jmsweng/15-1-cycloidal-drive/Pinion mount/readme.md

### Pinion mount for detector tables at 11-ID-B, 11-ID-C, and 11-ID-D

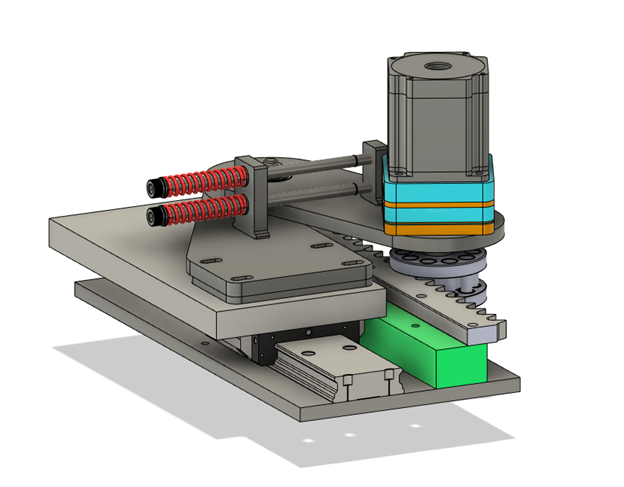
[picture p1: Pinion mount/Pictures/Pinion mount assembly.png]
Pinion mount assembly


Assembly pictured with 15:1 cycloidal gearbox mounted on a NEMA 34 stepper motor with an RPS-20 pinion

Assembly instructions
Components list is contained in assembly instructions.
