jmsweng/15-1-cycloidal-drive/Pinion mount/Component drawings/Old/readme.md

Drawings left for historical reasons, don't use.
