jmsweng/15-1-cycloidal-drive/Individual components/DXF Fies/Gearbox base, mild steel, 0.187.dxf

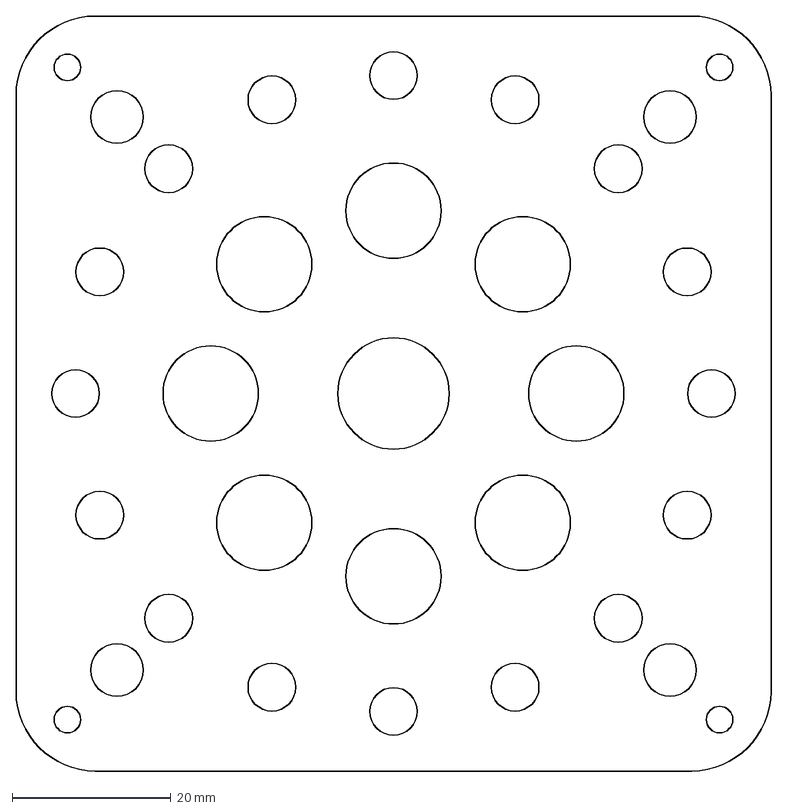
[picture p2: CAD file, 2024-03-28]
Individual components/DXF Fies/Gearbox base, mild steel, 0.187.dxf
95.0 x 95.0 mm
