jmsweng/15-1-cycloidal-drive/Individual components/Printed parts/Motor to gearbox spacer, printed.step

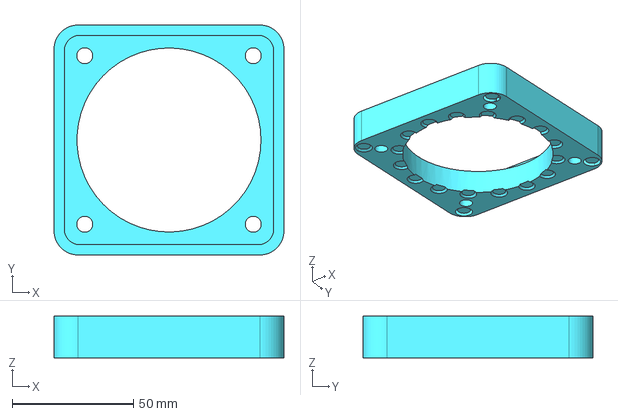
[picture p3: CAD file, 2024-03-28]
Individual components/Printed parts/Motor to gearbox spacer, printed.step
95.0 x 95.0 x 17.2 mm
