jmsweng/15-1-cycloidal-drive/Individual components/Step files/Output hub plate 2, 4130, 0.190.step

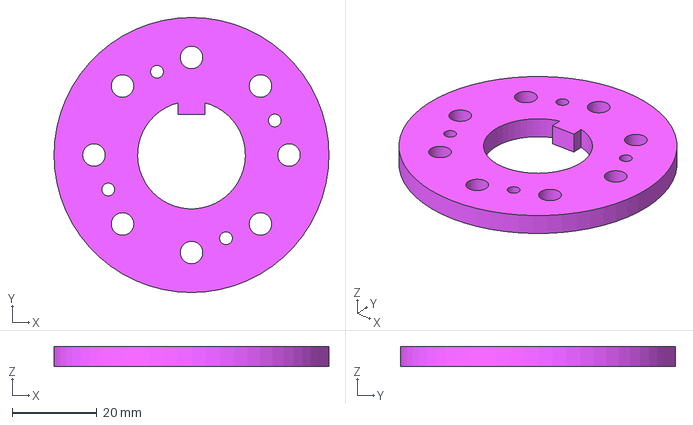
[picture p4: CAD file, 2024-03-28]
Individual components/Step files/Output hub plate 2, 4130, 0.190.step
64.8 x 64.8 x 4.83 mm
