jmsweng/15-1-cycloidal-drive/Pinion mount/Component drawings/Base plate, v2.step

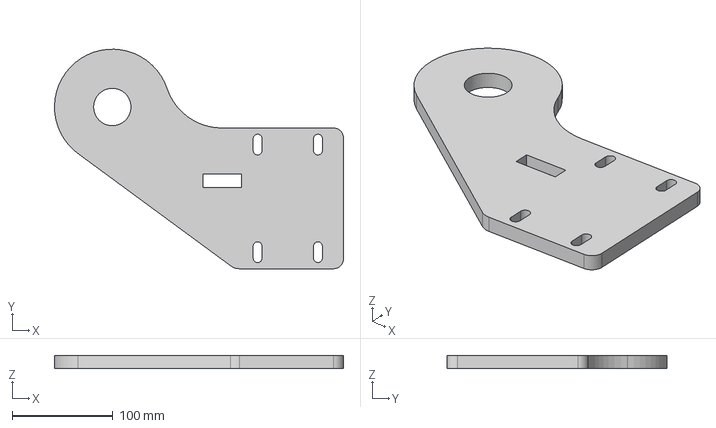
[picture p5: CAD file, 2024-06-21]
Pinion mount/Component drawings/Base plate, v2.step
287.3 x 218.3 x 12.7 mm
