jmsweng/15-1-cycloidal-drive/Pinion mount/Pinion mount.step

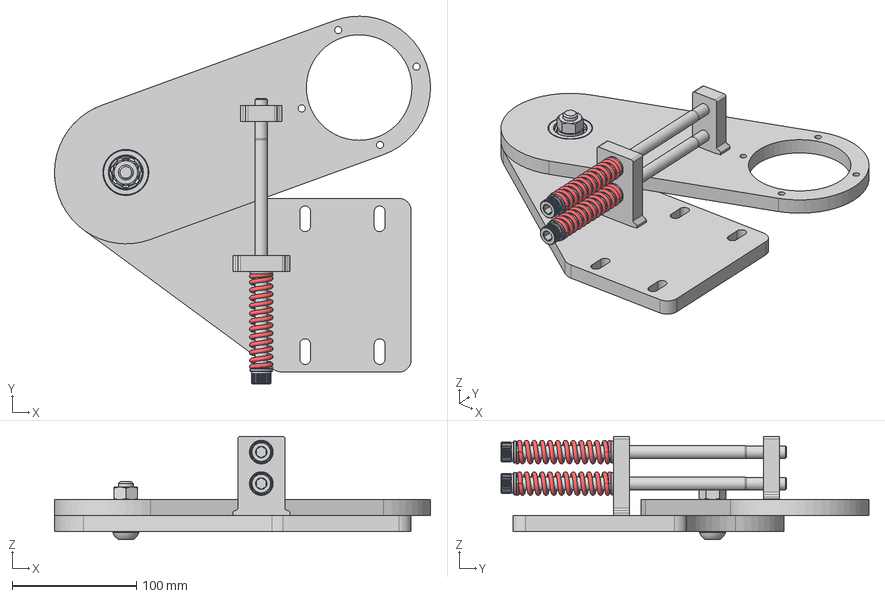
[picture p6: CAD file, 2024-06-21]
Pinion mount/Pinion mount.step
302.9 x 296.2 x 83.0 mm
5972K318_Ball Bearing x 2
90593A009_NO THREADS_Black-Oxide Steel Hex Nut
98687A138_General Purpose Steel Washer x 4
9657K438_Compression Spring x 2
91290A160_NO THREADS_Alloy Steel Socket Head Screw x 2
91239A620_NO THREADS
