jmsweng/15-1-cycloidal-drive/Individual components/DXF Fies/Gearbox pin retaining plate, Mild steel, 0.048.dxf

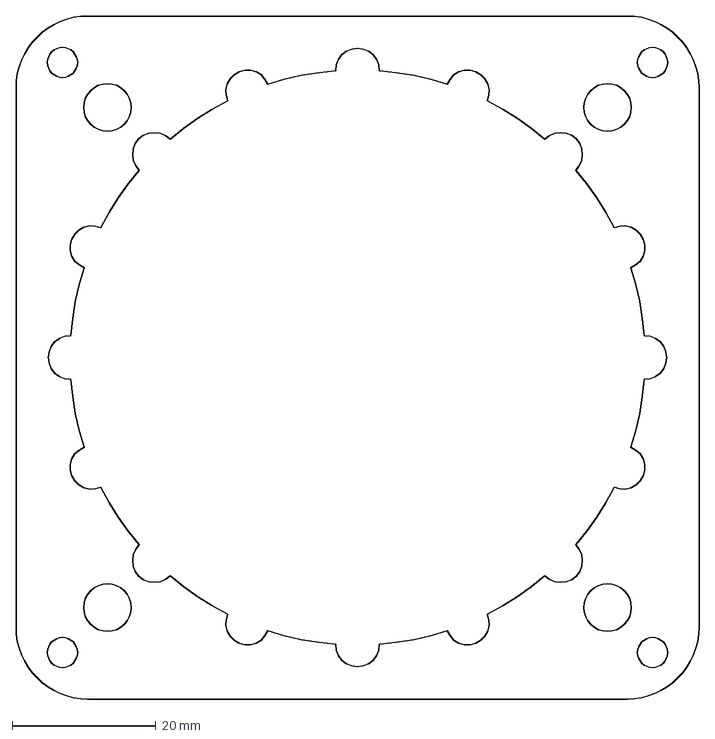
[picture p7: CAD file, 2024-03-28]
Individual components/DXF Fies/Gearbox pin retaining plate, Mild steel, 0.048.dxf
95.0 x 95.0 mm
