jmsweng/15-1-cycloidal-drive/Individual components/Printed parts/Input hub spacers.step

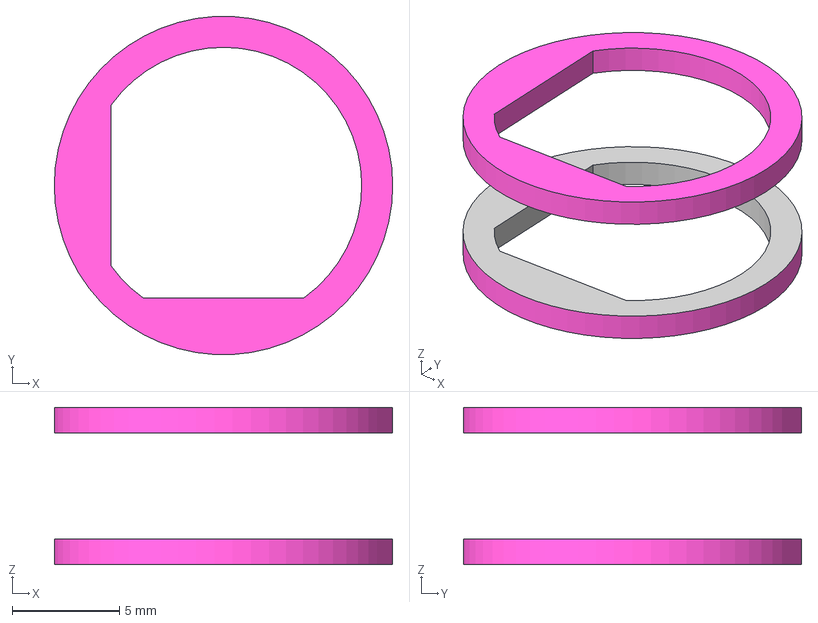
[picture p8: CAD file, 2024-03-28]
Individual components/Printed parts/Input hub spacers.step
15.8 x 15.8 x 7.34 mm
