jmsweng/15-1-cycloidal-drive/Individual components/Step files/Cycloidal disk, 4130, 0.190.step

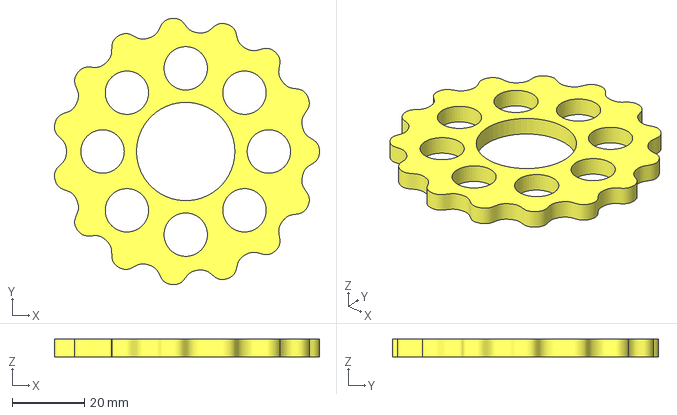
[picture p9: CAD file, 2024-03-28]
Individual components/Step files/Cycloidal disk, 4130, 0.190.step
73.3 x 73.6 x 4.87 mm
