jmsweng/15-1-cycloidal-drive/Pinion mount/Component drawings/Bearing spacer.step

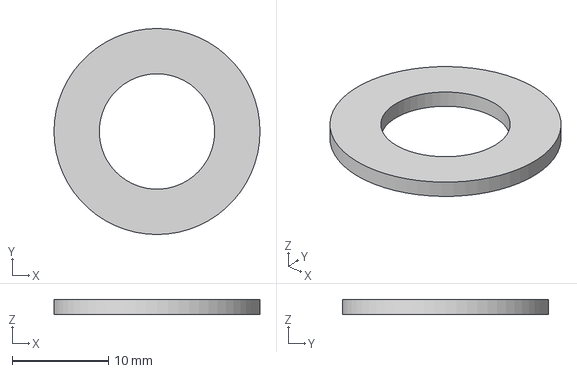
[picture p10: CAD file, 2024-04-02]
Pinion mount/Component drawings/Bearing spacer.step
21.4 x 21.4 x 1.52 mm
