jmsweng/15-1-cycloidal-drive/Individual components/Printed parts/Gearbox housing, plastic.step

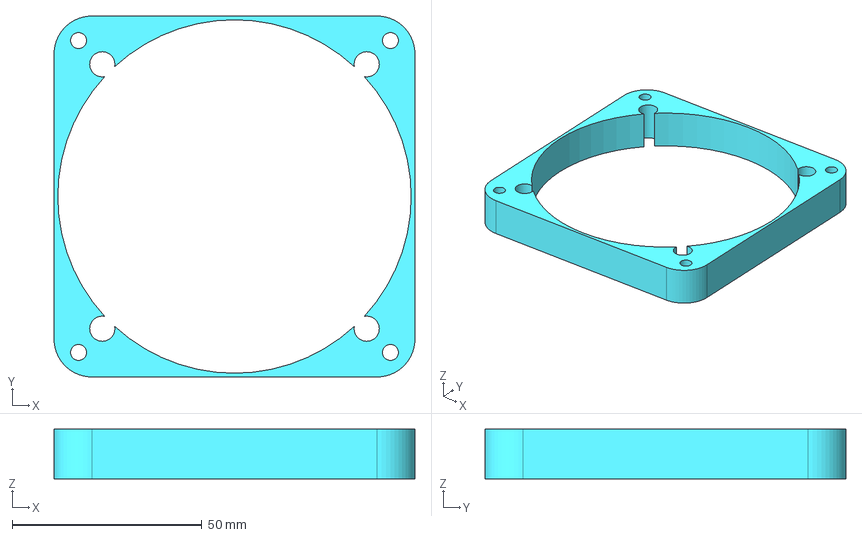
[picture p12: CAD file, 2024-03-28]
Individual components/Printed parts/Gearbox housing, plastic.step
95.0 x 95.0 x 13.1 mm
