jmsweng/15-1-cycloidal-drive/Individual components/Step files/Input concentric cam, 4130, 0.190.step

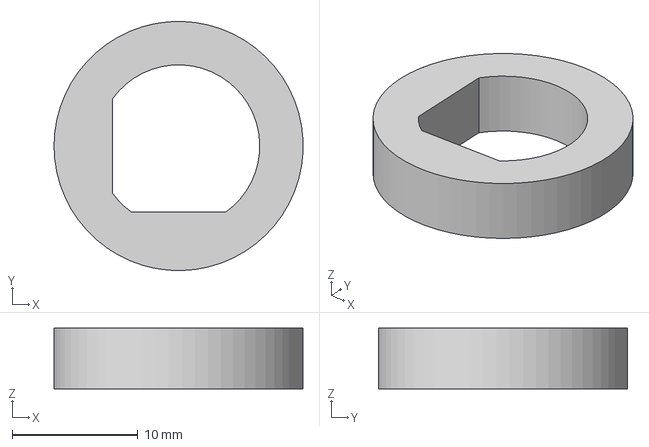
[picture p13: CAD file, 2024-03-28]
Individual components/Step files/Input concentric cam, 4130, 0.190.step
19.8 x 19.8 x 4.83 mm
