jmsweng/15-1-cycloidal-drive/Pinion mount/Component drawings/Tensioning spring retainer.step

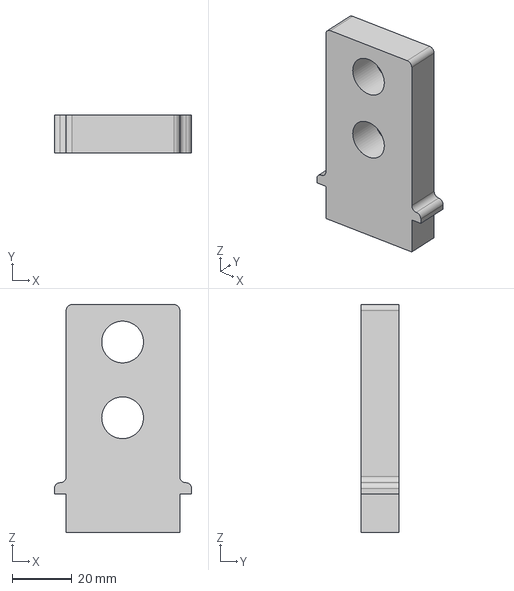
[picture p14: CAD file, 2024-04-02]
Pinion mount/Component drawings/Tensioning spring retainer.step
46.1 x 12.7 x 76.4 mm
