jmsweng/15-1-cycloidal-drive/Individual components/Printed parts/Gearbox pin retaining plate, plastic.step

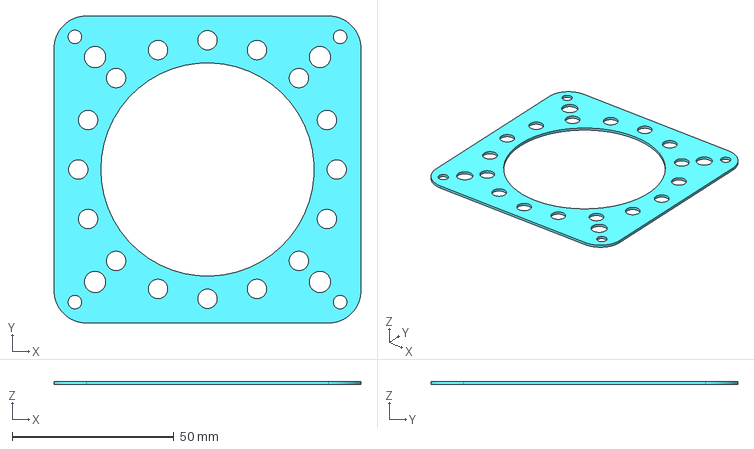
[picture p16: CAD file, 2024-03-28]
Individual components/Printed parts/Gearbox pin retaining plate, plastic.step
95.0 x 95.0 x 1.00 mm
