jmsweng/15-1-cycloidal-drive/Pinion mount/Component drawings/Top arm.step

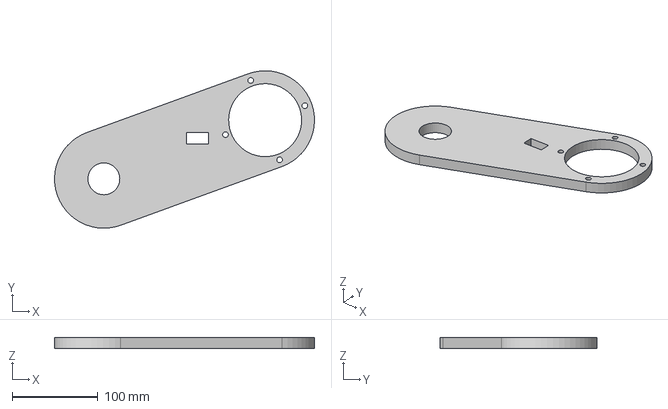
[picture p17: CAD file, 2024-04-02]
Pinion mount/Component drawings/Top arm.step
302.9 x 183.4 x 12.7 mm
