jmsweng/15-1-cycloidal-drive/Individual components/DXF Fies/Input concentric cam, 4130, 0.190.dxf

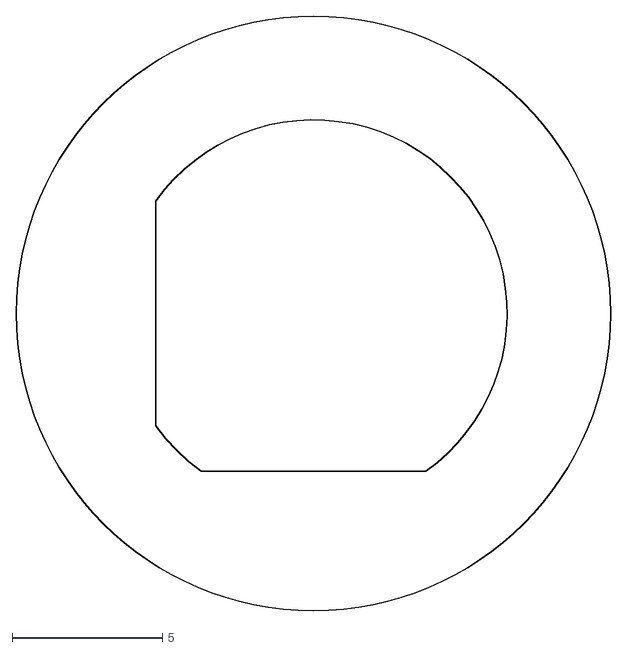
[picture p18: CAD file, 2024-03-28]
Individual components/DXF Fies/Input concentric cam, 4130, 0.190.dxf
19.8 x 19.8
