jmsweng/15-1-cycloidal-drive/Individual components/Printed parts/Ring pin spacers.step

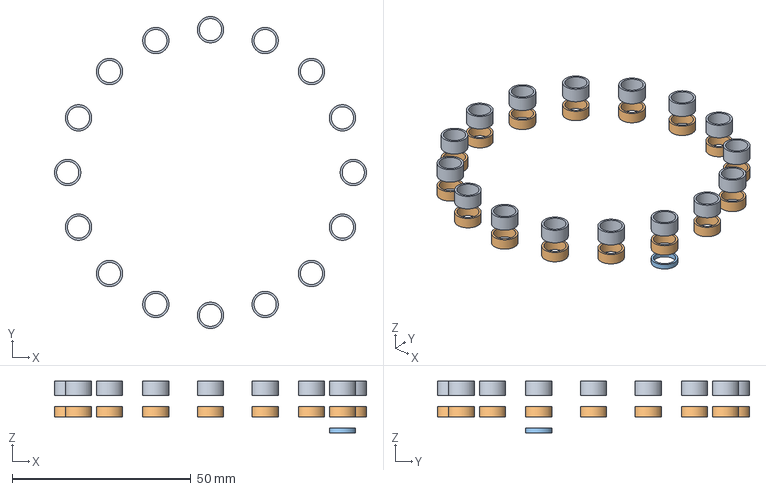
[picture p19: CAD file, 2024-03-28]
Individual components/Printed parts/Ring pin spacers.step
87.4 x 87.4 x 14.5 mm
