jmsweng/15-1-cycloidal-drive/Individual components/DXF Fies/Unnamed-Shape2DView.dxf

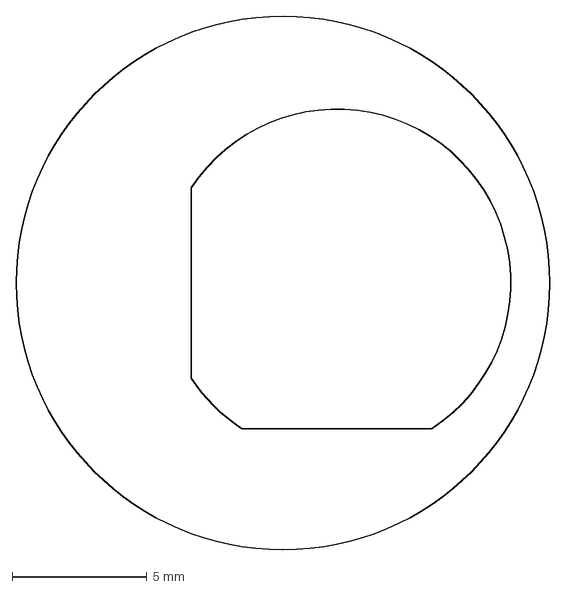
[picture p20: CAD file, 2024-03-28]
Individual components/DXF Fies/Unnamed-Shape2DView.dxf
19.8 x 19.8 mm
