jmsweng/15-1-cycloidal-drive/Individual components/Step files/Gearbox base, mild steel, 0.187.step

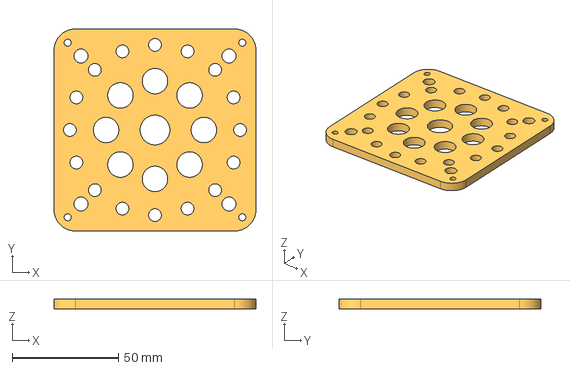
[picture p21: CAD file, 2024-03-28]
Individual components/Step files/Gearbox base, mild steel, 0.187.step
95.0 x 95.0 x 4.75 mm
