jmsweng/15-1-cycloidal-drive/Pinion mount/Component drawings/Base plate spacer.step

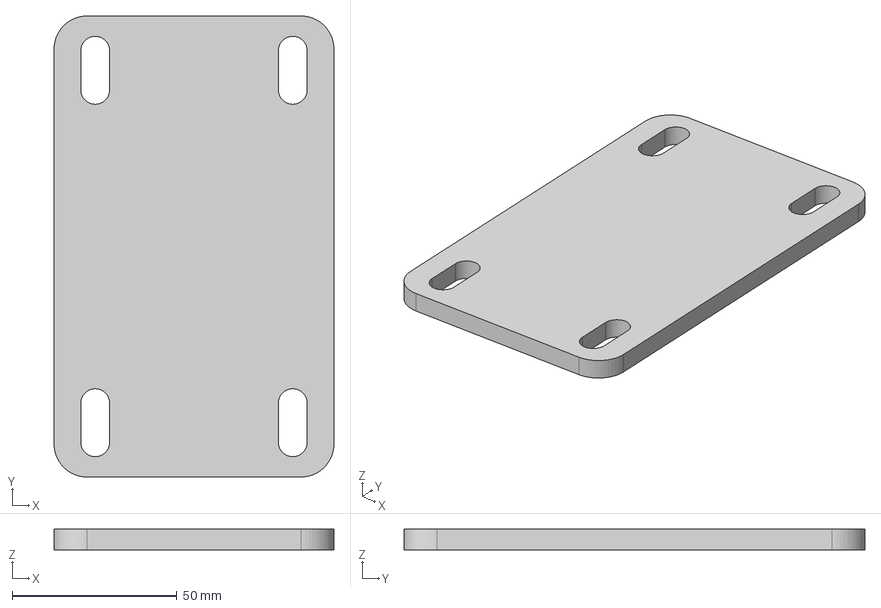
[picture p22: CAD file, 2024-04-02]
Pinion mount/Component drawings/Base plate spacer.step
85.0 x 140.0 x 6.35 mm
