jmsweng/15-1-cycloidal-drive/Individual components/DXF Fies/Gearbox output bearing plate, mild steel, 0.375.dxf

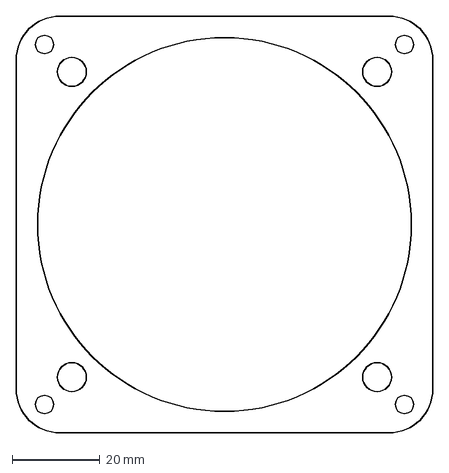
[picture p23: CAD file, 2024-03-28]
Individual components/DXF Fies/Gearbox output bearing plate, mild steel, 0.375.dxf
95.0 x 95.0 mm
