jmsweng/15-1-cycloidal-drive/Pinion mount/Component drawings/Tensioning tab, threaded.step

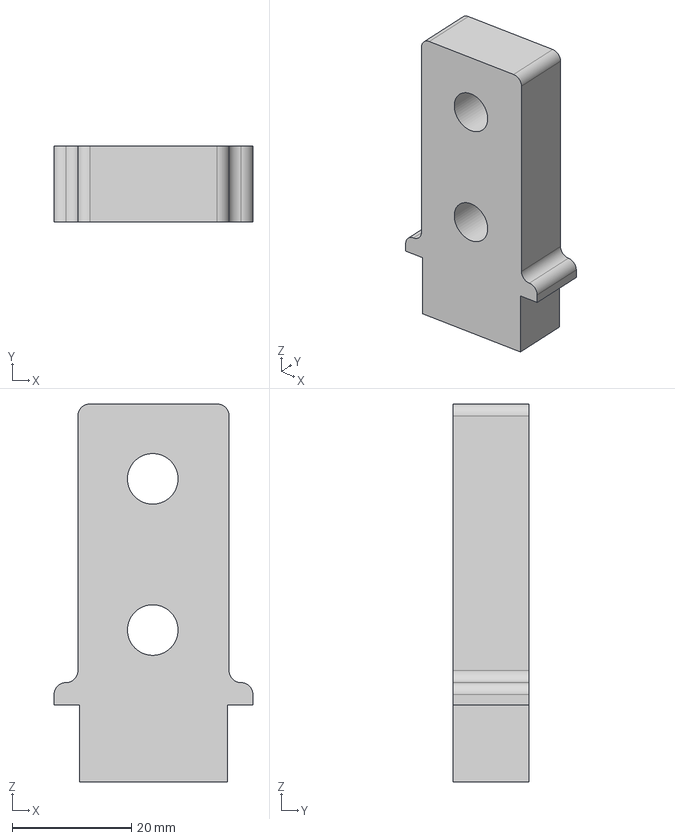
[picture p24: CAD file, 2024-04-02]
Pinion mount/Component drawings/Tensioning tab, threaded.step
33.4 x 12.7 x 63.5 mm
