jmsweng/15-1-cycloidal-drive/Individual components/DXF Fies/Output hub plate 1, 4130, 0.190.dxf

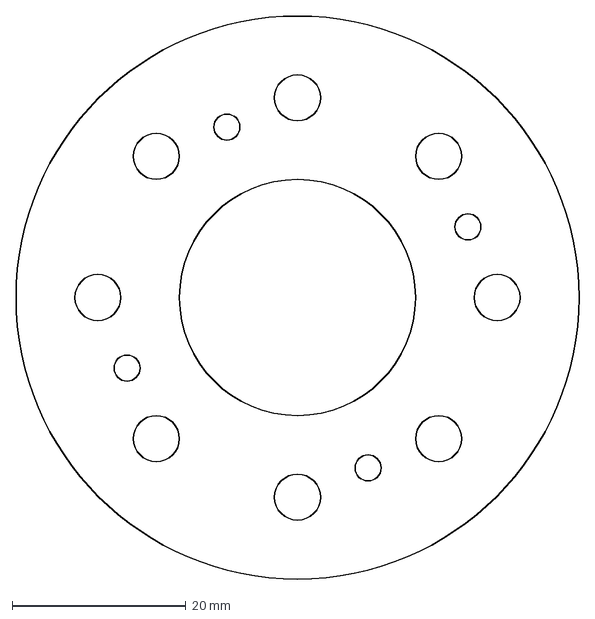
[picture p25: CAD file, 2024-03-28]
Individual components/DXF Fies/Output hub plate 1, 4130, 0.190.dxf
64.8 x 64.8 mm
