jmsweng/15-1-cycloidal-drive/Individual components/Step files/Gearbox output bearing plate, mild steel, 0.375.step

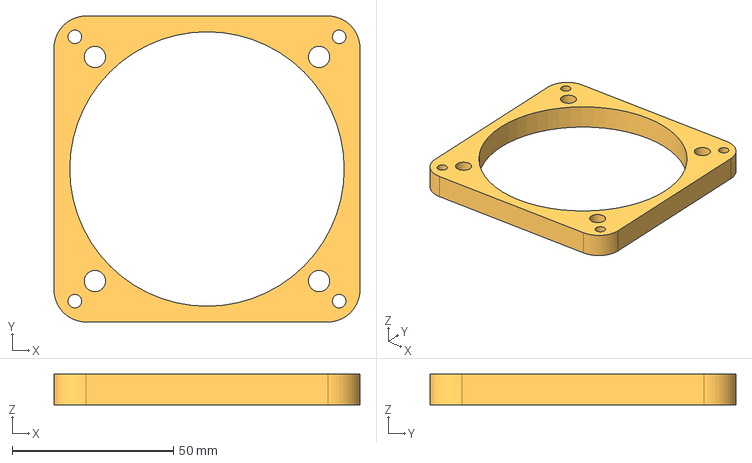
[picture p26: CAD file, 2024-03-28]
Individual components/Step files/Gearbox output bearing plate, mild steel, 0.375.step
95.0 x 95.0 x 9.53 mm
