jmsweng/15-1-cycloidal-drive/Pinion mount/Component drawings/Carriage spacer.step

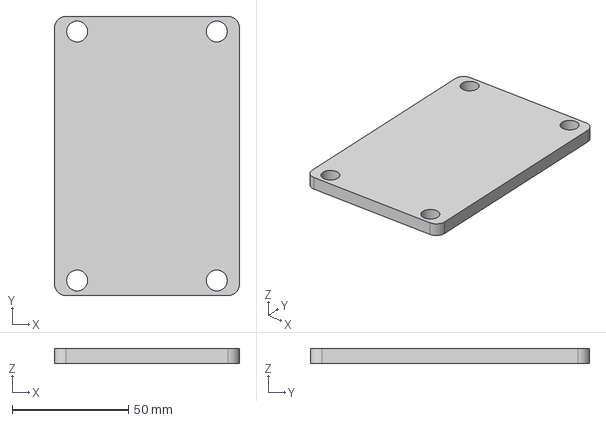
[picture p27: CAD file, 2024-04-02]
Pinion mount/Component drawings/Carriage spacer.step
79.5 x 120.0 x 6.36 mm
