jmsweng/15-1-cycloidal-drive/Pinion mount/Component drawings/Base plate.step

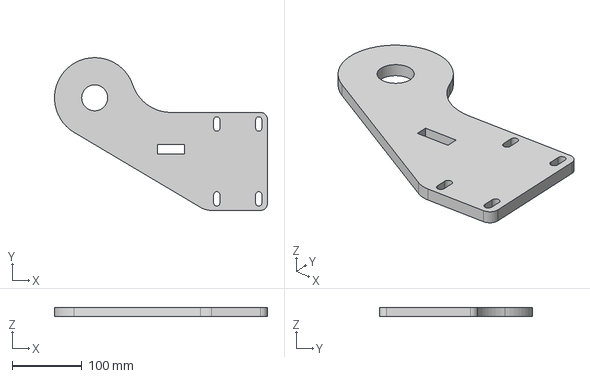
[picture p29: CAD file, 2024-04-02]
Pinion mount/Component drawings/Base plate.step
304.4 x 218.4 x 12.7 mm
