jmsweng/15-1-cycloidal-drive/Individual components/DXF Fies/Input eccentric cam, bigger hole, 4130, 0.190.dxf

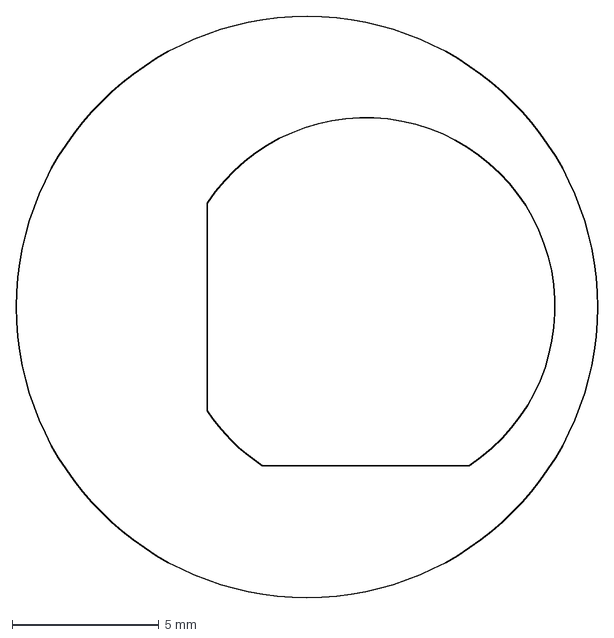
[picture p33: CAD file, 2024-03-28]
Individual components/DXF Fies/Input eccentric cam, bigger hole, 4130, 0.190.dxf
19.8 x 19.8 mm
