jmsweng/15-1-cycloidal-drive/Individual components/DXF Fies/Cycloidal disk, 4130, 0.190.dxf

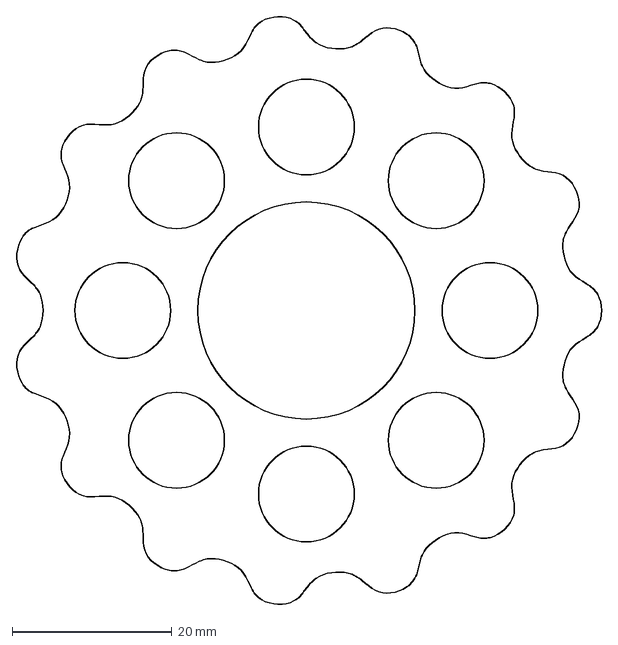
[picture p35: CAD file, 2024-03-28]
Individual components/DXF Fies/Cycloidal disk, 4130, 0.190.dxf
73.3 x 73.7 mm
