jmsweng/15-1-cycloidal-drive/Individual components/Step files/Gearbox pin retaining plate, Mild steel, 0.048.step

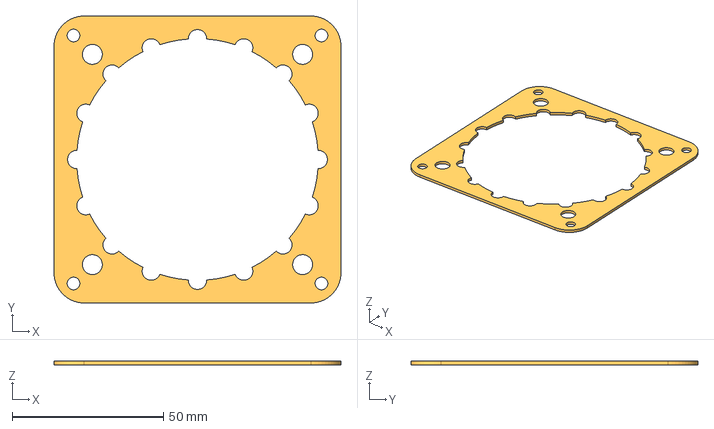
[picture p36: CAD file, 2024-03-28]
Individual components/Step files/Gearbox pin retaining plate, Mild steel, 0.048.step
95.0 x 95.0 x 1.22 mm
