jmsweng/15-1-cycloidal-drive/(list of files, cad)

Other CAD files:
Individual components/Step files/Input eccentric cam, 4130, 0.190.step
Individual components/Step files/Input eccentric cam, bigger hole, 4130, 0.step
Pinion mount/Component drawings/Top arm, v2.step
Individual components/Step files/Input eccentric cam 2, bigger hole, 4130, 0.step
Individual components/Step files/Input eccentric cam 2, 4130, 0.190.step
Individual components/Step files/Input concentric cam, bigger hole, 4130, 0.190.step
Pinion mount/Component drawings/Old/Pinion mount.step
