jmsweng/15-1-cycloidal-drive/Pinion mount/Assembly_instructions.md

# Assembly instructions for pinion mount

Pinion mount assembly

## Table of contents
- [Components list](#components)
    - [Hardware](#hardware)
    - [Laser cut parts](#laser-cut-parts)
    - [Misc needed](#misc-needed)
- [Assembly instructions](#assembly-instructions)
    - [Top arm](#top-arm)
    - [Base plate](#base-plate)
    - [Hinge assembly](#hinge-assembly)
    - [Tensioning spring installation](#tensioning-spring-installation)

## Components:
### Hardware
- 2x - 6301 Ball bearing, McMaster Carr #5972K318
- 1x - M12 x 40mm Hex cap screw, McMaster Carr #91239A620
- 1x - M12 Nut, McMaster Carr #90593A009
- 2x - M10 x 220 mm hex cap screw, partially threaded, McMaster-Carr #91290A160
- 4x - M10 Steel washer, 18mm OD x 10.5mm ID, McMaster-Carr #98687A138
- 2x - 0.75” OD x 0.48” ID x 3” springs, McMaster-Carr #9657K438

### Laser cut parts
#### Base plate
Cut from 0.500" mild steel

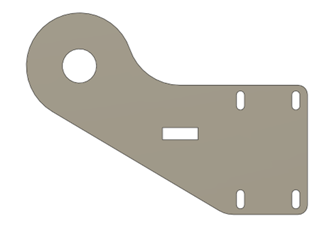
[picture p38: Pinion mount/Pictures/Base plate.png]
Base plate component

#### Top arm
Cut from 0.500" mild steel

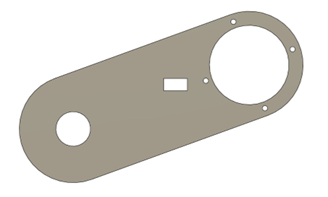
[picture p39: Pinion mount/Pictures/Top arm.png]
Top arm component

#### Bearing spacer
Cut from 0.060" 304 stainless steel

Bearing spacer component
#### Tensioning spring tabs:
Cut from 0.500" mild steel
Right tab shown should be tapped with M10 threads

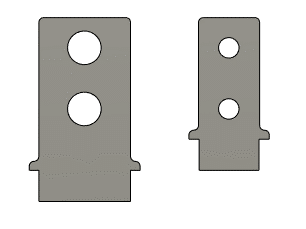
[picture p40: Pinion mount/Pictures/Tensioning spring tabs.png]
Tensioning spring tabs


### Misc needed
- Bearing retaining compound
    - Recommended Loctite 638
- Threadlocker
    - Recommended Loctite 620
## Assembly instructions:

### Top arm
The motor mounting holes on the top arm are undersized due to laser cutting requirements and are ~5.7 mm as manufactured. Drill the four following holes below out to fit M6 screws, a ¼” (6.35 mm) drill bit should work for this. Holes are highlighted in blue.

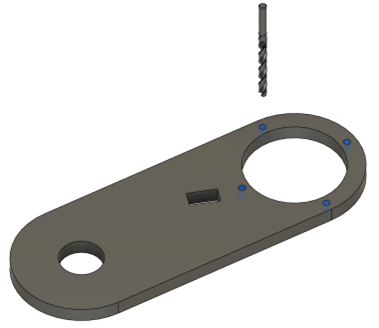
[picture p41: Pinion mount/Pictures/Drilling locations.png]
Top arm drilling


Shown below is the view of the top of the top arm component.

Top arm component, top view

Place the part with the top face facing down onto a flat surface so that it looks like the view shown below.

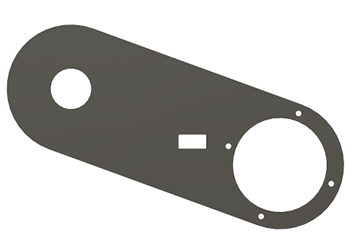
[picture p42: Pinion mount/Pictures/Top arm bottom view.png]
Top arm, bottom view


Clean highlighted hole before proceeding. Also clean the outside of the 6301 bearing, but try to avoid getting cleaner inside of the bearing. Wiping surfaces with solvent such as acetone or alcohol should be sufficient. 
Make sure parts are dry before proceeding. Apply retaining compound to the inside of the highlighted hole and press in the 6301 ball bearing in from the top. This should press in relatively easy, but use an arbor press or other tool if necessary. The top surface of the ball bearing should be flush with the top surface of the plate. The top surface of the plate is facing down in the illustration below. Retaining compound should start hardening in ~10 minutes and reaches full strength in 24 hours.

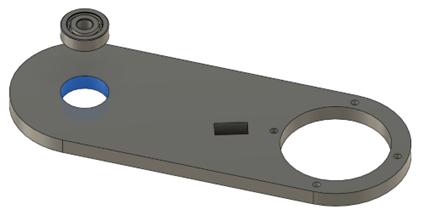
[picture p43: Pinion mount/Pictures/Top arm bearing insertion.png]
Top arm bearing insertion


Lightly sand the highlighted portion of the tensioning spring tab that is threaded for M10 holes to prepare for gluing. Clean surface and allow to dry before gluing.

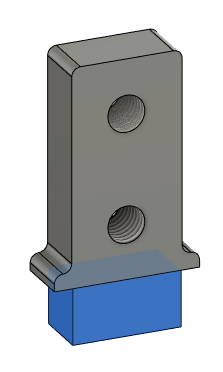
[picture p44: Pinion mount/Pictures/Threaded tensioning tab, glue.png]
Tensioning tab, threaded, glue section


Ensure highlighted mating surfaces are clean before proceeding. Top surface of the plate is now facing up in the illustrations. Note the position of the bearing, it should be flush with the top.

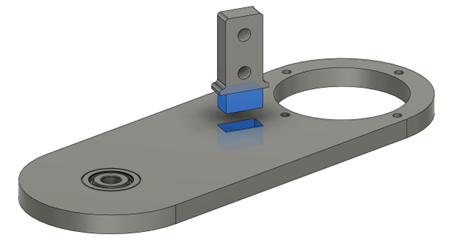
[picture p45: Pinion mount/Pictures/Top arm gluing.png]
Top arm and tensioning tab mating surfaces


Apply epoxy or other adhesive to surfaces and press tab in from the top so that the assembly looks like below. Clean off any excess epoxy before drying.

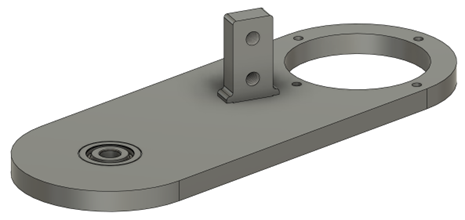
[picture p46: Pinion mount/Pictures/Glued top arm.png]
Glued top arm


### Base plate
Shown below is the top view of the base plate component.

Base plate component

Repeat previous procedure to install 6301 bearing in the highlighted hole. The bearing should be flush with the bottom surface of the base plate:

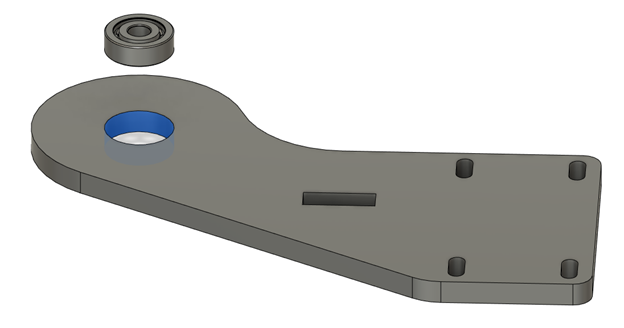
[picture p47: Pinion mount/Pictures/Base plate bearing insertion.png]
Base plate bearing insertion


Lightly sand the highlighted portion of the tensioning spring tab that is not threaded for M10 holes to prepare for gluing. Clean surface and allow to dry before gluing.

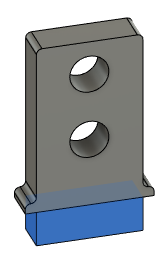
[picture p48: Pinion mount/Pictures/Unthreaded tensioning tab, glue.png]
Tensioning tab, unthreaded, glue section


Ensure highlighted mating surfaces are clean before proceeding.

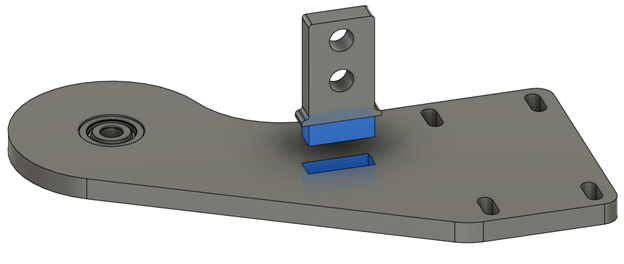
[picture p49: Pinion mount/Pictures/Base plate gluing.png]
Base plate and tensioning tab mating surfaces


Apply epoxy or other adhesive to surfaces and press tab in from the top so that the assembly looks like below. Clean off any excess epoxy before drying.

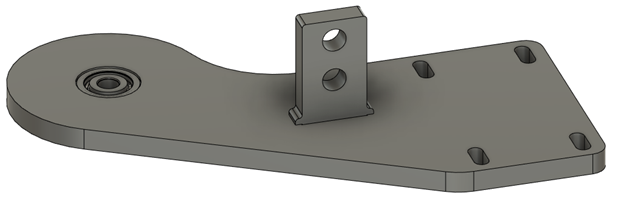
[picture p50: Pinion mount/Pictures/Glued base plate.png]
Glued base plate


### Hinge assembly
Once epoxy is cured on both parts, assemble the top arm and base plate as shown below. Parts highlighted in blue are the M16 button head screw, bearing spacer, and M16 nut. Apply thread locker to hold the nut on to the M16 screw. Recommend Loctite 242 or 243. Wicking thread locker such as Loctite 290 is also fine if part is already assembled. If wicking thread locker is used apply at position indicated by green arrow in illustration.

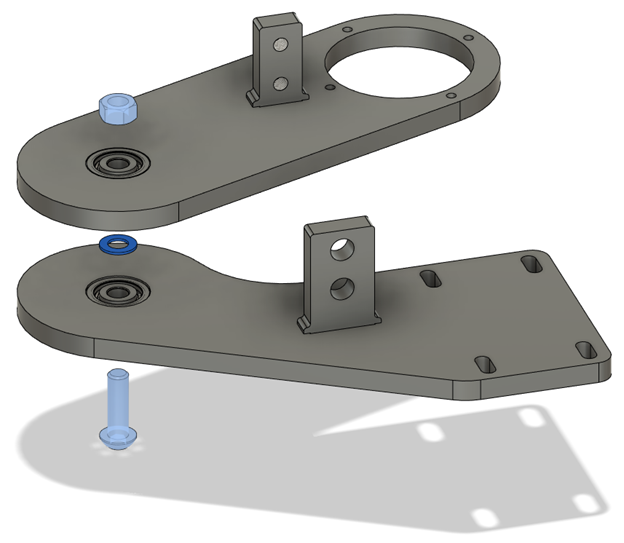
[picture p51: Pinion mount/Pictures/Hinge bolt insertion.png]
Hinge bolt insertion


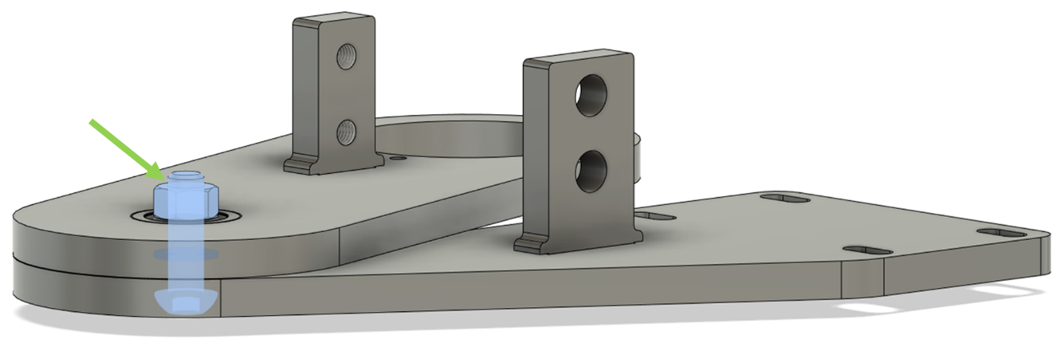
[picture p52: Pinion mount/Pictures/Hinge bolt, threadlocker location.png]
Wicking threadlocker position


### Tensioning spring installation
Insert tensioning screws, washer, tensioning spring, and washer into tensioning tab holes as shown below. Tensioning screws are M10 x 220mm partially threaded hex cap screws. Washers are M10 washers. Springs are 0.75” OD x 0.48” ID x 3” springs, McMaster-Carr part #9657K438. 

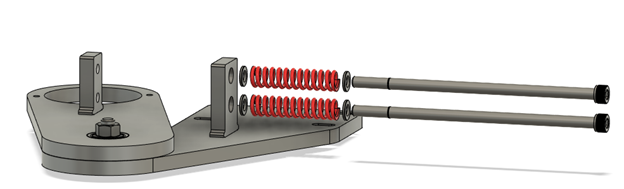
[picture p53: Pinion mount/Pictures/Tensioning spring installation.png]
Tensioning spring installation


After installation, screws should be tensioned such that the distance from the face of the tensioning tab to the bottom of the hex cap screw is ~66 mm (as shown below on the pink spacer). This distance is not super critical, if using the tensioning screws and springs in the original spec it should not be possible to tighten them down such that the pinion will not be able to skip out of the rack before the max rated force is exceeded. 

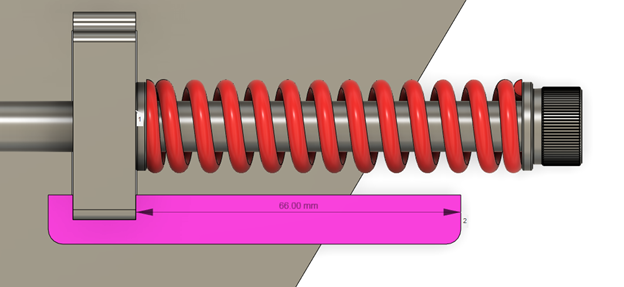
[picture p54: Pinion mount/Pictures/Tension setting.png]
Tension setting
