jmsweng/15-1-cycloidal-drive/Individual components/Part drawings/Gearbox base.pdf

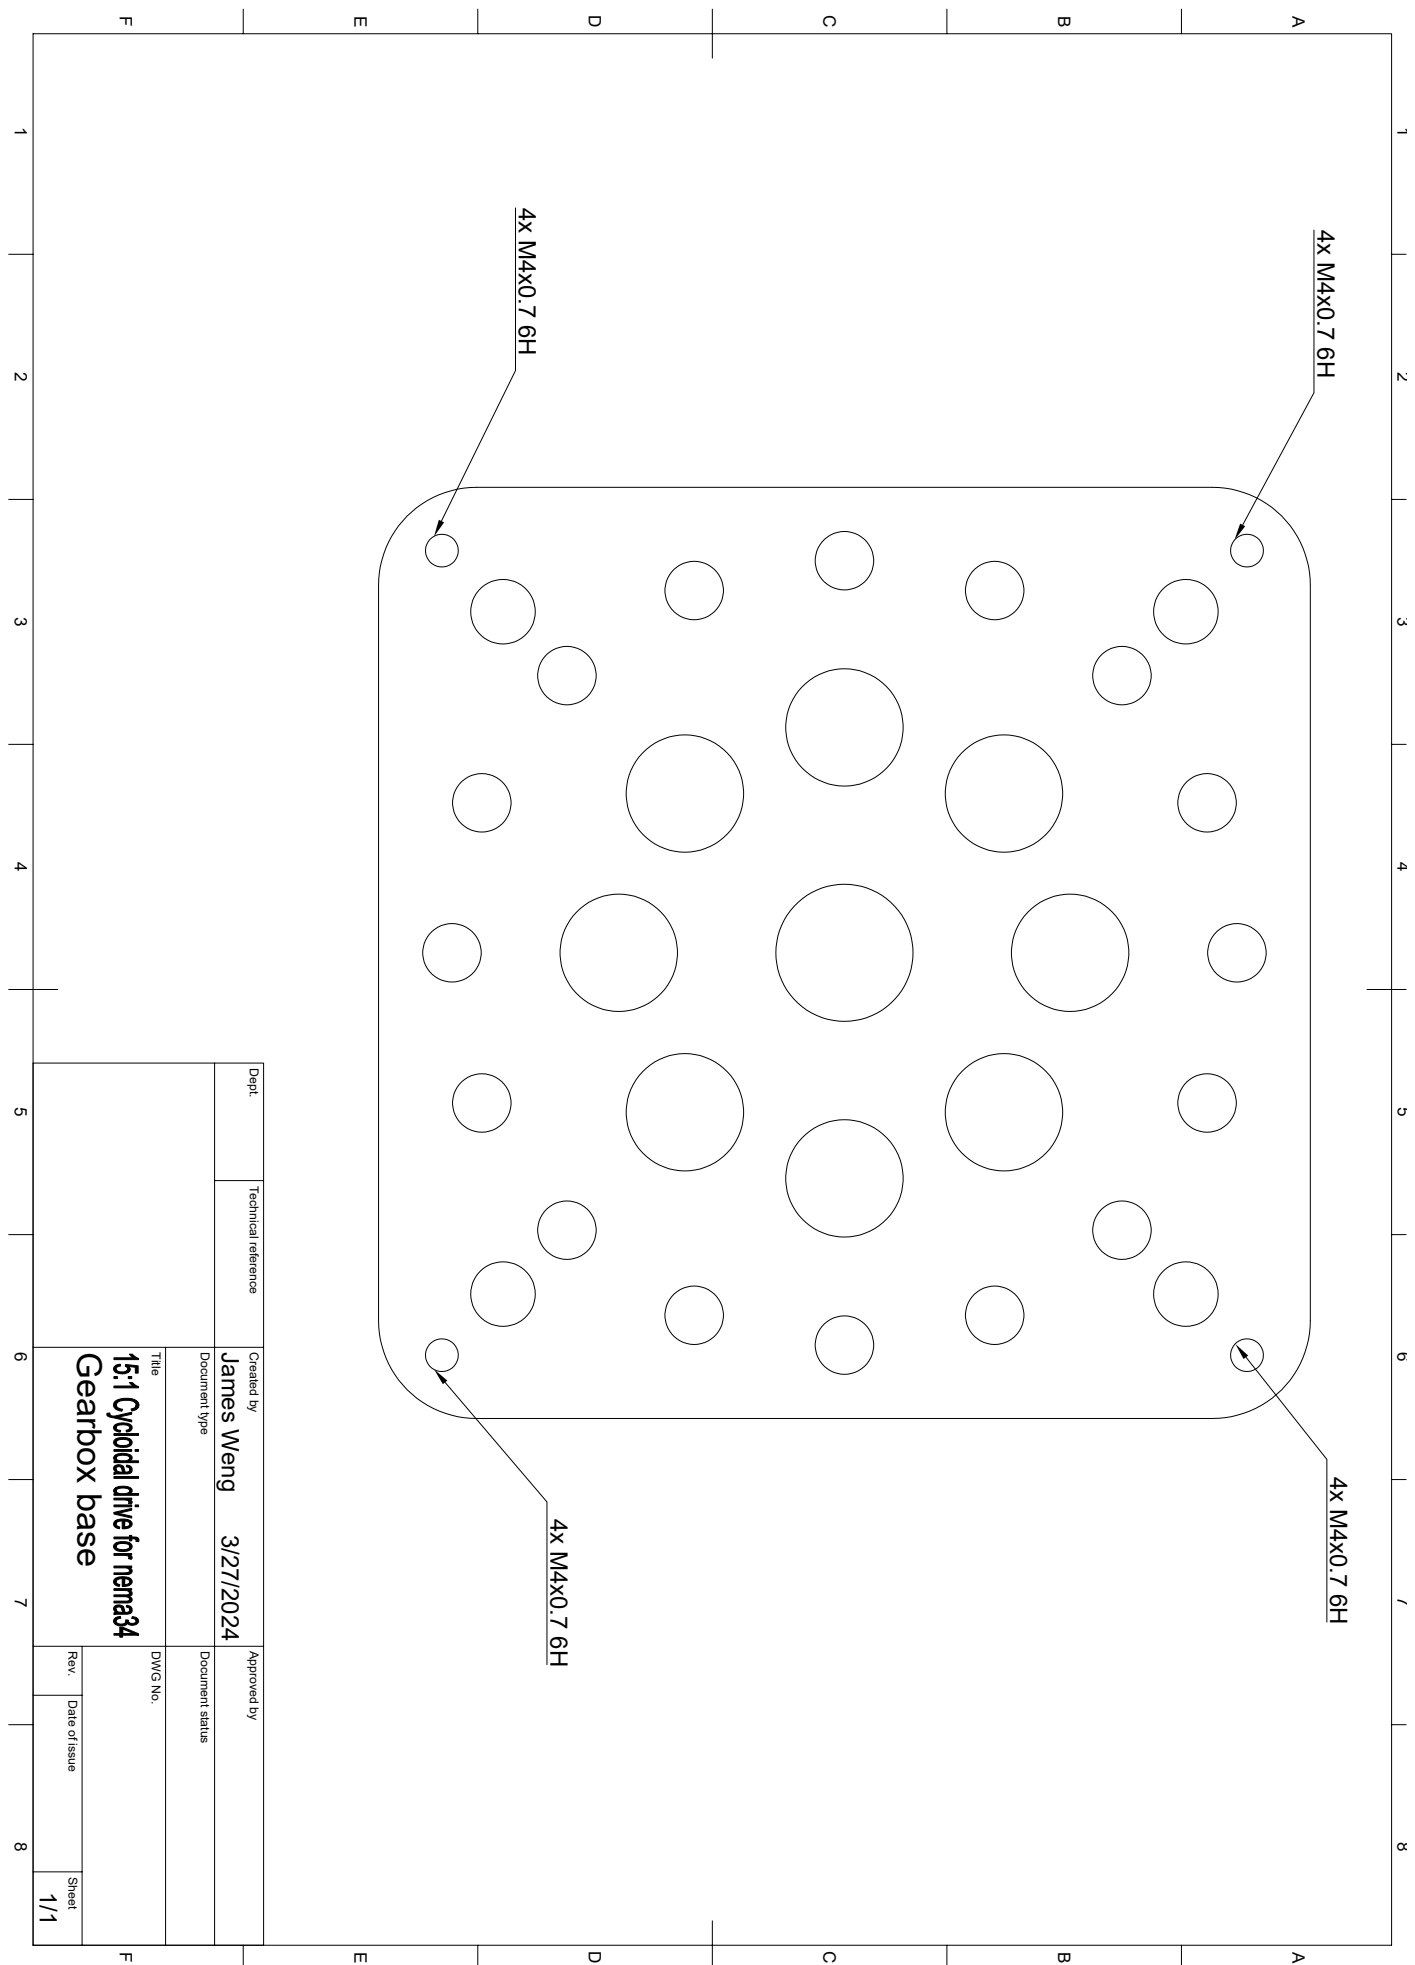
[picture p55: page 1]

1 A 2 3 4 5 6 7 8 1 2 3 4 5 6 7 8 FEDCB FEDCBA Dept. Technical reference Created by Approved by Title DWG No. Document type Document status Rev. Date of issue Sheet 3/27/2024 1/1 Gearbox base James Weng 4x M4x0.7 6H 4x M4x0.7 6H 4x M4x0.7 6H 4x M4x0.7 6H
