jmsweng/15-1-cycloidal-drive/(commit log)

2024-04-02 Create Assembly instructions.md
2024-04-02 Rename Assembly instructions.md to Assembly_instructions.md
2024-06-21 Update and rename Pinion mount/Component drawings/Top arm.step to Pinion mount/Component drawings/Old/Top arm.step
    Moved deprecated file
    [Top arm.step]
2024-06-21 Update and rename Pinion mount/Component drawings/Base plate.step to Pinion mount/Component drawings/Old/Base plate.step
    Move deprecated file
    [Base plate.step]
2024-06-21 Rename Pinion mount/Pinion mount.step to Pinion mount/Component drawings/Old/Pinion mount.step
    [Pinion mount.step]
